seenemikk/LibreWatch-HW/README.md

# LibreWatch-HW

This repository contains hardware related files for [LibreWatch](https://github.com/seenemikk/LibreWatch) smartwatch.
