seenemikk/LibreWatch-HW/housing/bottom.stl

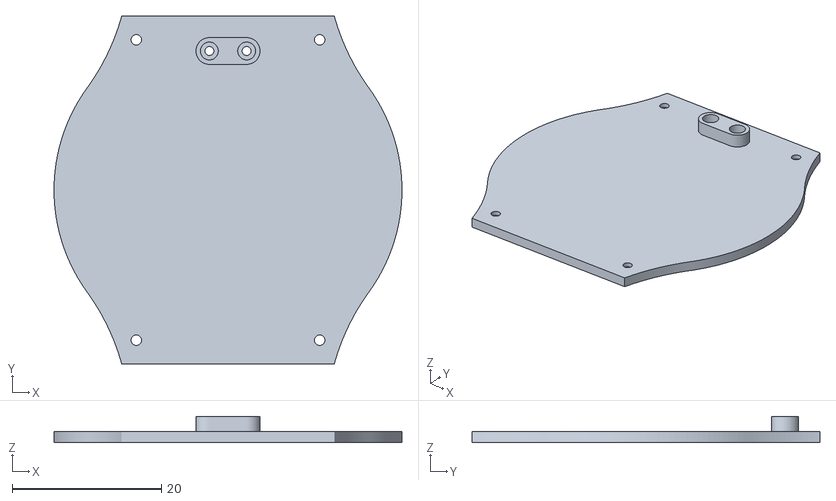
[picture p1: CAD file, 2023-06-04]
housing/bottom.stl
46.7 x 46.7 x 3.50
