seenemikk/LibreWatch-HW/housing/top.stl

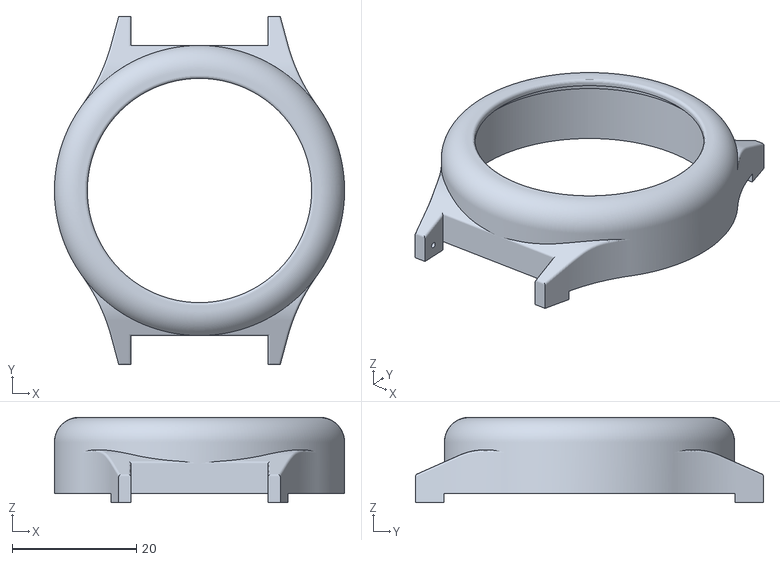
[picture p2: CAD file, 2023-06-04]
housing/top.stl
46.7 x 56.0 x 13.7
