seenemikk/LibreWatch-HW/electronics/doc/schematic.pdf

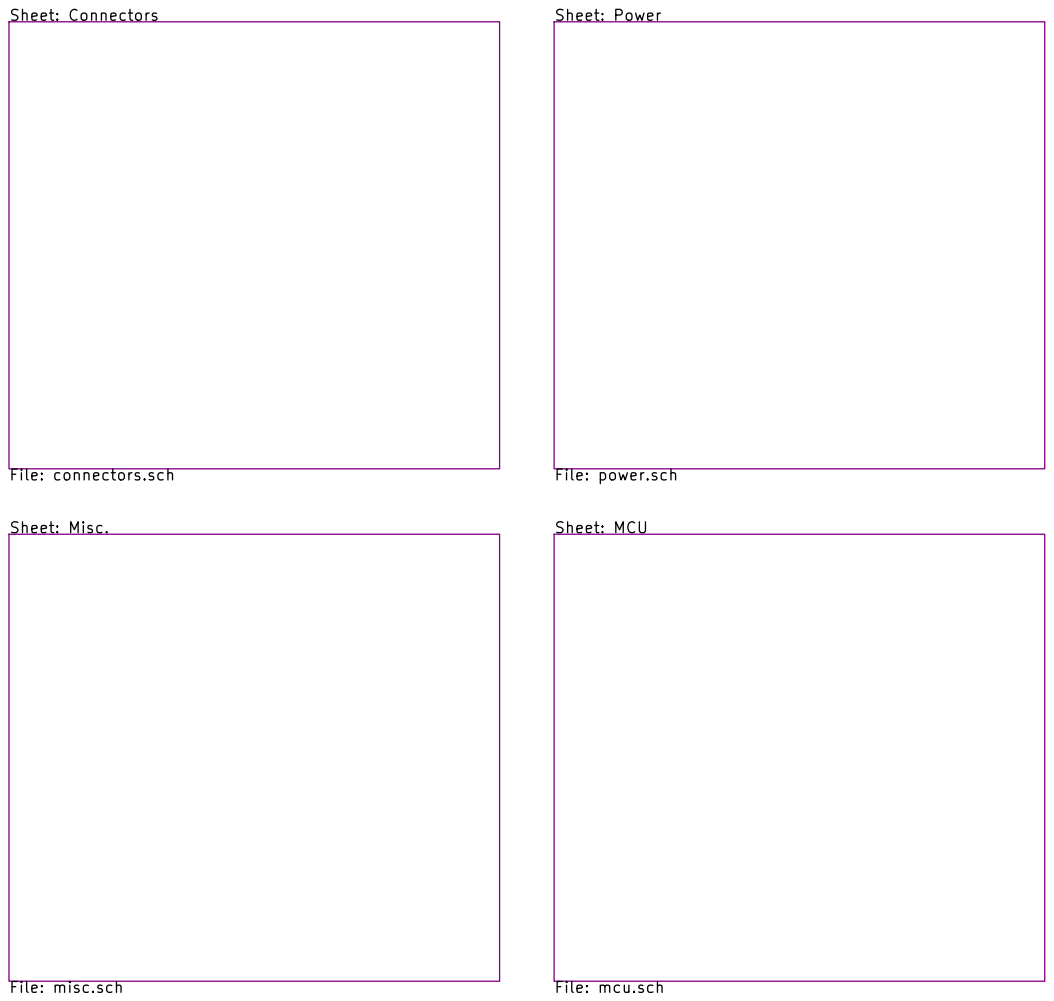
[picture p3: page 1]

Id: 1/5 Title: File: SmartWatch.sch Sheet: /

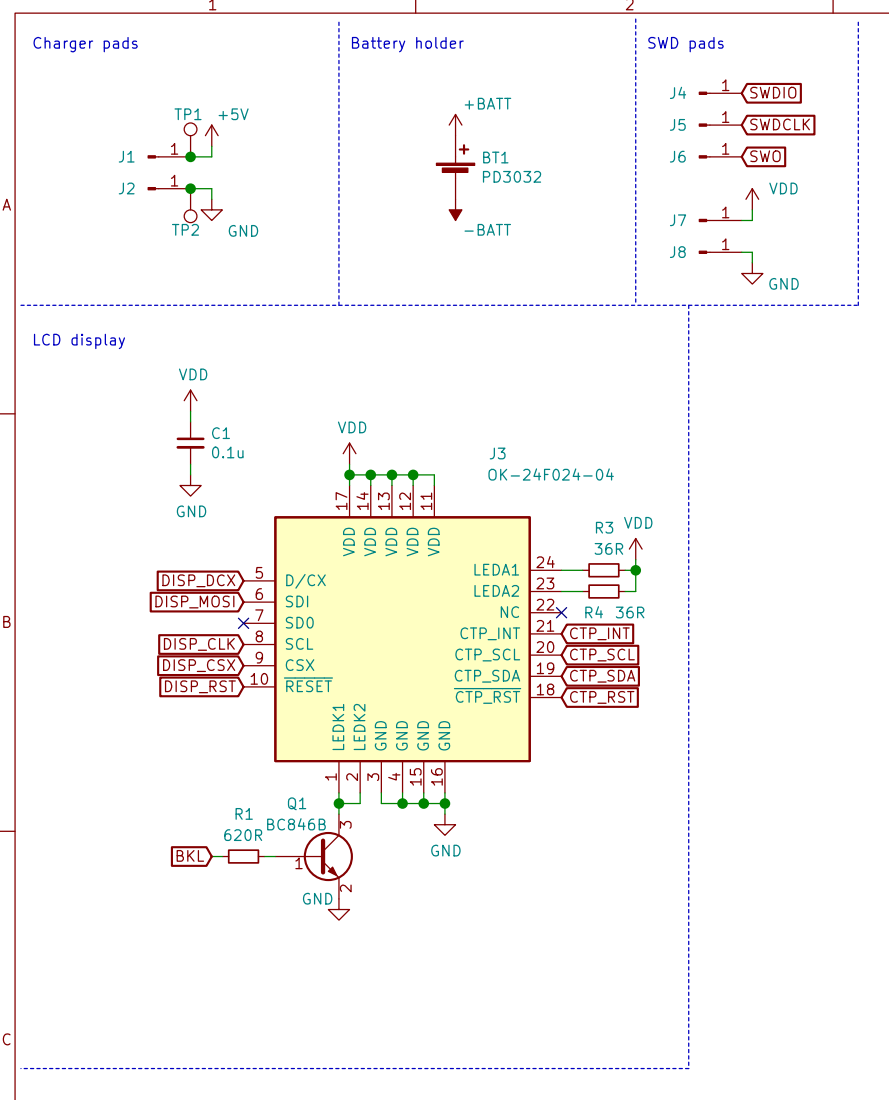
[picture p4: page 2]

1 RESET 10 VDD 11 VDD 12 VDD 13 VDD 14 GND 15 GND 16 VDD 17 CTP_RST 18 CTP_SDA 19 LEDK2

4 D/CX 5 SDI 6 SD0 7 SCL 8 CSX 9

File: connectors.sch Sheet: /Connectors/ GND

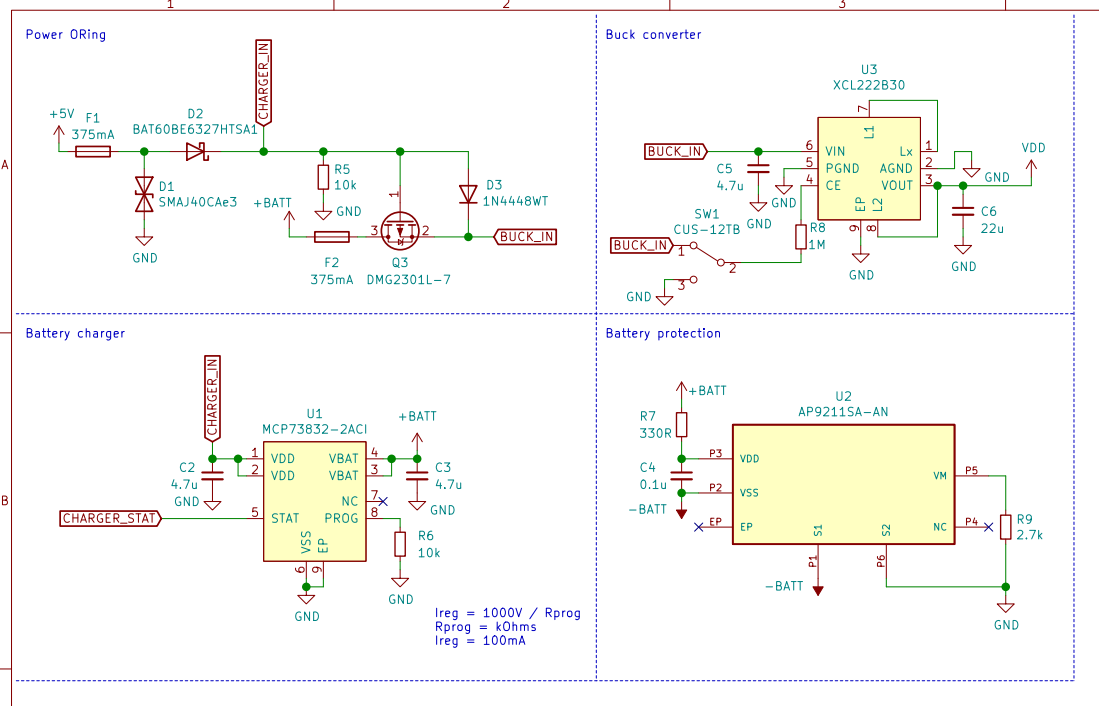
[picture p5: page 3]

File: power.sch Sheet: /Power/
Id: 3/5 Title: Power

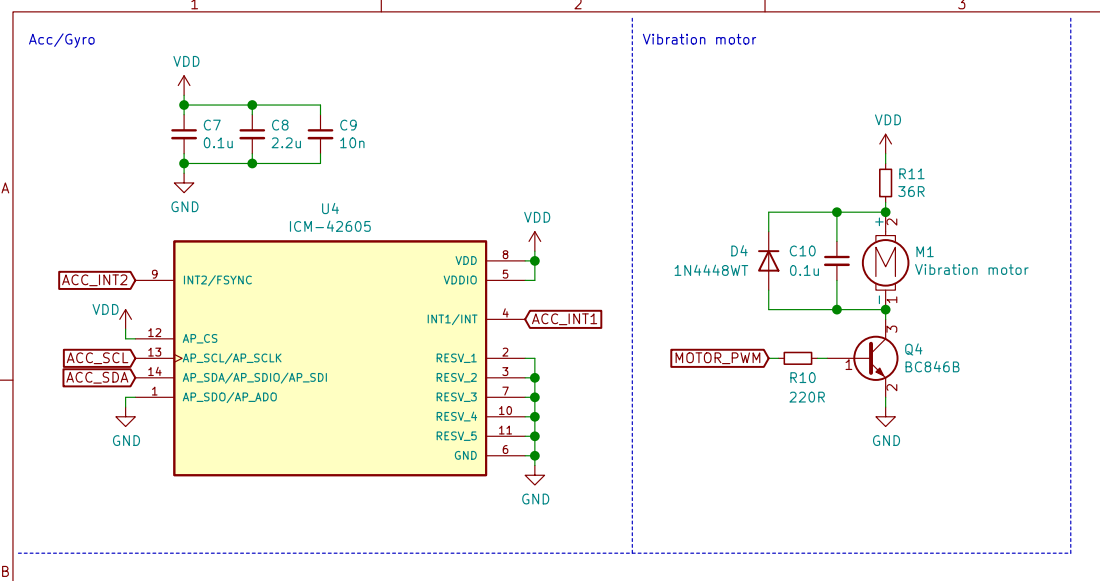
[picture p6: page 4]

Id: 4/5 Title: Misc. File: misc.sch Sheet: /Misc./

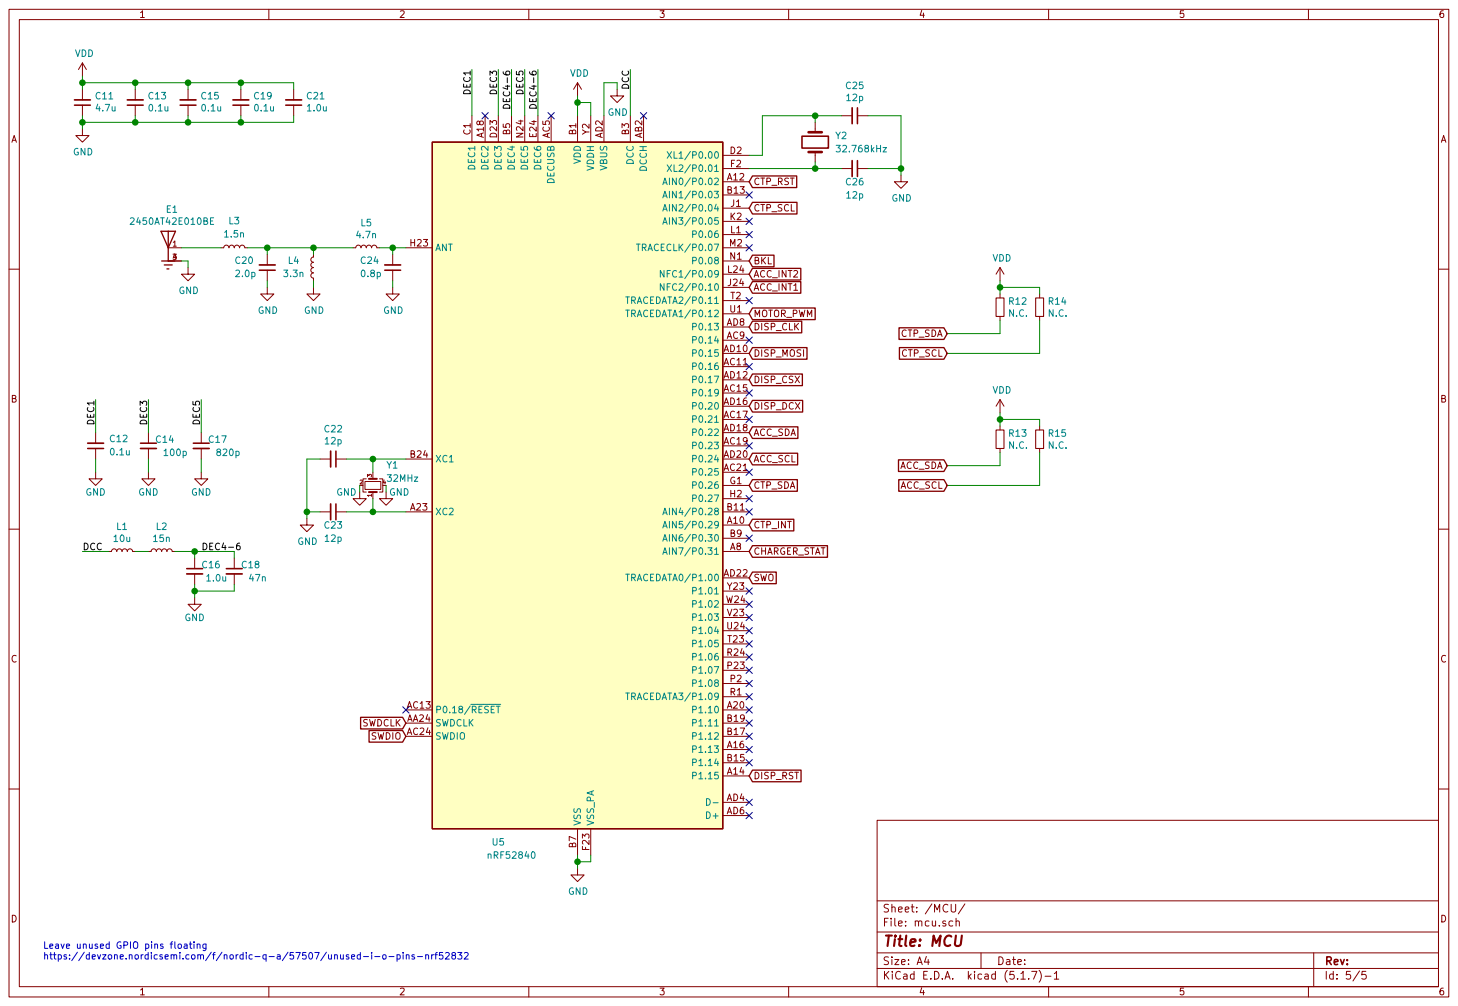
[picture p7: page 5]

File: mcu.sch Sheet: /MCU/
Id: 5/5 Title: MCU

Leave unused GPIO pins floating
https://devzone.nordicsemi.com/f/nordic-q-a/57507/unused-i-o-pins-nrf52832
