seenemikk/LibreWatch-HW/electronics/src/SmartWatch.kicad_pcb

## KiCad design electronics/src/SmartWatch.kicad_pcb (2023-06-04)

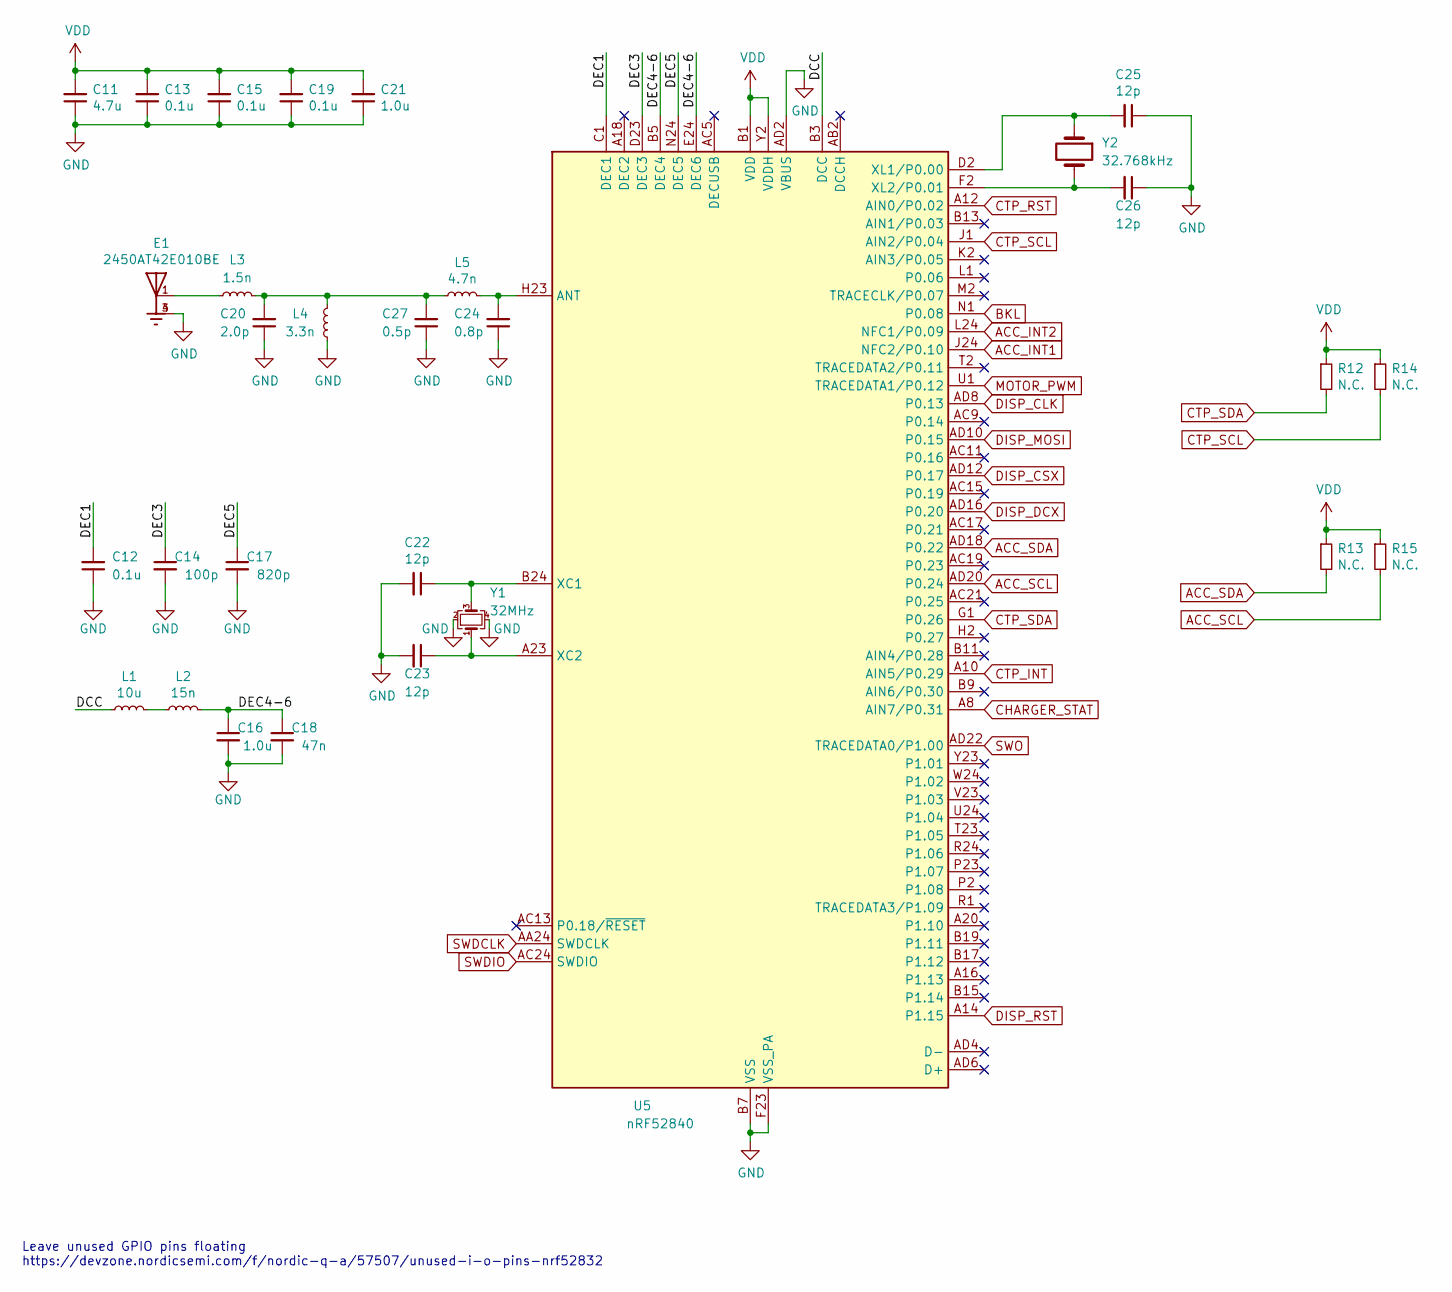
[picture p8: schematic mcu.kicad_sch]

Parts:
C11: 4.7u; C_0603_1608Metric
C12, C13, C15, C19: 0.1u; C_0402_1005Metric
C14: 100p; C_0402_1005Metric
C16, C21: 1.0u; C_0603_1608Metric
C17: 820p; C_0402_1005Metric
C18: 47n; C_0402_1005Metric
C20: 2.0p; C_0402_1005Metric
C22, C23, C25, C26: 12p; C_0402_1005Metric
C24: 0.8p; C_0402_1005Metric
C27: 0.5p; C_0402_1005Metric
E1: 2450AT42E010BE; XDCR_2450AT42E010BE; PARTREV 1.3
L1: 10u; L_0603_1608Metric
L2: 15n; L_0402_1005Metric
L3: 1.5n; L_0402_1005Metric
L4: 3.3n; L_0402_1005Metric
L5: 4.7n; L_0402_1005Metric
R12, R13, R14, R15: N.C.; R_0402_1005Metric
U5: nRF52840; Nordic_AQFN-73-1EP_7x7mm_P0.5mm
Y1: 32MHz; Crystal_SMD_2016-4Pin_2.0x1.6mm
Y2: 32.768kHz; Crystal_SMD_2012-2Pin_2.0x1.2mm

Connections:
/MCU/DCC: L1.1, U5.B3 (DCC)
/MCU/DEC1: C12.2, U5.C1 (DEC1)
/MCU/DEC3: C14.1, U5.D23 (DEC3)
/MCU/DEC4-6: C16.1, C18.1, L2.2, U5.B5 (DEC4), U5.E24 (DEC6)
/MCU/DEC5: C17.1, U5.N24 (DEC5)
ACC_INT1: U5.J24 (NFC2/P0.10); also elsewhere on the board
ACC_INT2: U5.L24 (NFC1/P0.09); also elsewhere on the board
ACC_SCL: R15.2, U5.AD20 (P0.24); also elsewhere on the board
ACC_SDA: R13.2, U5.AD18 (P0.22); also elsewhere on the board
BKL: U5.N1 (P0.08); also elsewhere on the board
CHARGER_STAT: U5.A8 (AIN7/P0.31); also elsewhere on the board
CTP_INT: U5.A10 (AIN5/P0.29); also elsewhere on the board
CTP_RST: U5.A12 (AIN0/P0.02); also elsewhere on the board
CTP_SCL: R14.2, U5.J1 (AIN2/P0.04); also elsewhere on the board
CTP_SDA: R12.2, U5.G1 (P0.26); also elsewhere on the board
DISP_CLK: U5.AD8 (P0.13); also elsewhere on the board
DISP_CSX: U5.AD12 (P0.17); also elsewhere on the board
DISP_DCX: U5.AD16 (P0.20); also elsewhere on the board
DISP_MOSI: U5.AD10 (P0.15); also elsewhere on the board
DISP_RST: U5.A14 (P1.15); also elsewhere on the board
GND: C11.1, C12.1, C13.1, C14.2, C15.1, C16.2, C17.2, C18.2, C19.1, C20.1, C21.1, C22.2, C23.2, C24.1, C25.1, C26.1, C27.1, E1.3, E1.4, L4.1, U5.AD2 (VBUS), U5.B7 (VSS), U5.EP (VSS), U5.F23 (VSS_PA), Y1.2, Y1.4; also elsewhere on the board
MOTOR_PWM: U5.U1 (TRACEDATA1/P0.12); also elsewhere on the board
unnamed: C20.2, C27.2, L3.2, L4.2, L5.1
unnamed: C22.1, U5.B24 (XC1), Y1.3
unnamed: C23.1, U5.A23 (XC2), Y1.1
unnamed: C24.2, L5.2, U5.H23 (ANT)
unnamed: C25.2, U5.D2 (XL1/P0.00), Y2.1
unnamed: C26.2, U5.F2 (XL2/P0.01), Y2.2
unnamed: E1.1, L3.1
unnamed: L1.2, L2.1
SWDCLK: U5.AA24 (SWDCLK); also elsewhere on the board
SWDIO: U5.AC24 (SWDIO); also elsewhere on the board
SWO: U5.AD22 (TRACEDATA0/P1.00); also elsewhere on the board
VDD: C11.2, C13.2, C15.2, C19.2, C21.2, R12.1, R13.1, R14.1, R15.1, U5.A22 (VDD), U5.AD14 (VDD), U5.AD23 (VDD), U5.B1 (VDD), U5.W1 (VDD), U5.Y2 (VDDH); also elsewhere on the board

Notes on the sheet:
Leave unused GPIO pins floating https://devzone.nordicsemi.com/f/nordic-q-a/57507/unused-i-o-pins-nrf52832

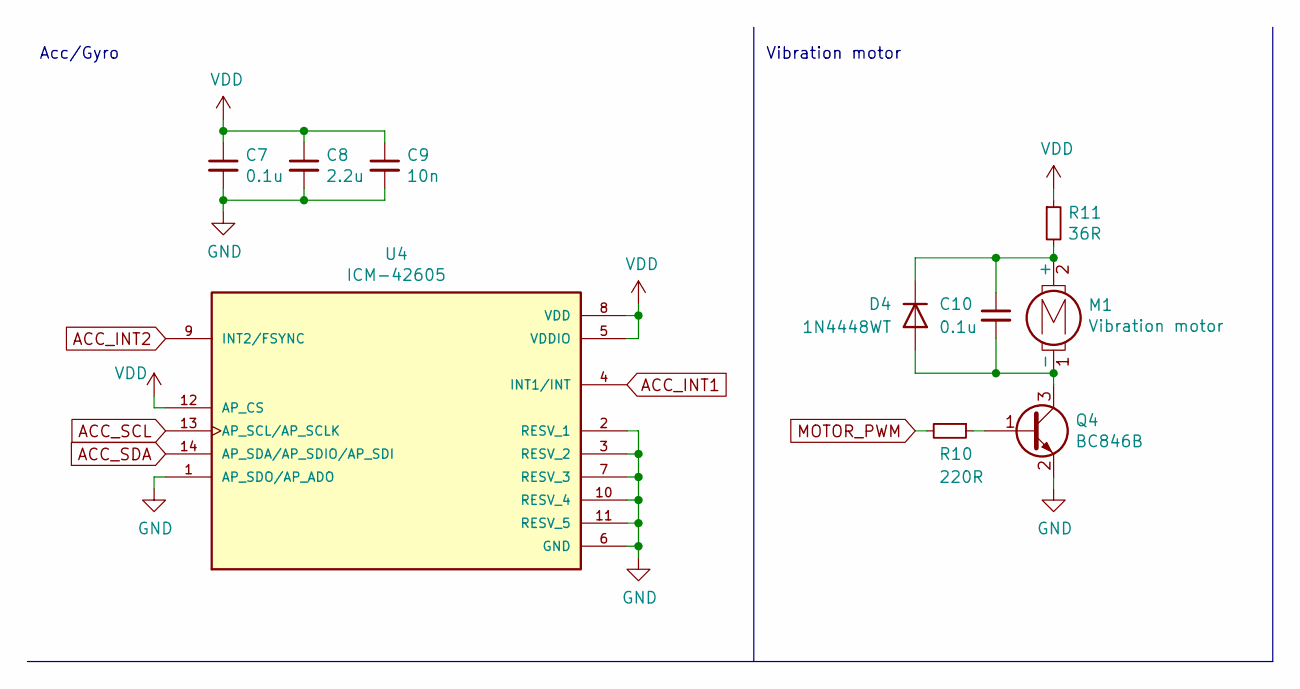
[picture p9: schematic misc.kicad_sch]

Parts:
C7: 0.1u; C_0402_1005Metric
C8: 2.2u; C_0402_1005Metric
C9: 10n; C_0402_1005Metric
C10: 0.1u; C_0603_1608Metric
D4: 1N4448WT; SOD-523F
M1: Vibration motor; Battery_Pads
Q4: BC846B; SOT-23
R10: 220R; R_0402_1005Metric
R11: 36R; R_0603_1608Metric
U4: ICM-42605; PQFN50P300X250X97-14N; PARTREV 0.4

Connections:
ACC_INT1: U4.4 (INT1/INT); also elsewhere on the board
ACC_INT2: U4.9 (INT2/FSYNC); also elsewhere on the board
ACC_SCL: U4.13 (AP_SCL/AP_SCLK); also elsewhere on the board
ACC_SDA: U4.14 (AP_SDA/AP_SDIO/AP_SDI); also elsewhere on the board
GND: C7.2, C8.2, C9.2, Q4.2 (E), U4.1 (AP_SDO/AP_ADO), U4.2 (RESV_1), U4.3 (RESV_2), U4.6 (GND), U4.7 (RESV_3), U4.10 (RESV_4), U4.11 (RESV_5); also elsewhere on the board
MOTOR_PWM: R10.2; also elsewhere on the board
unnamed: C10.1, D4.1 (K), M1.2 (+), R11.2
unnamed: C10.2, D4.2 (A), M1.1 (-), Q4.3 (C)
unnamed: Q4.1 (B), R10.1
VDD: C7.1, C8.1, C9.1, R11.1, U4.5 (VDDIO), U4.8 (VDD), U4.12 (AP_CS); also elsewhere on the board

Notes on the sheet:
Acc/Gyro
Vibration motor

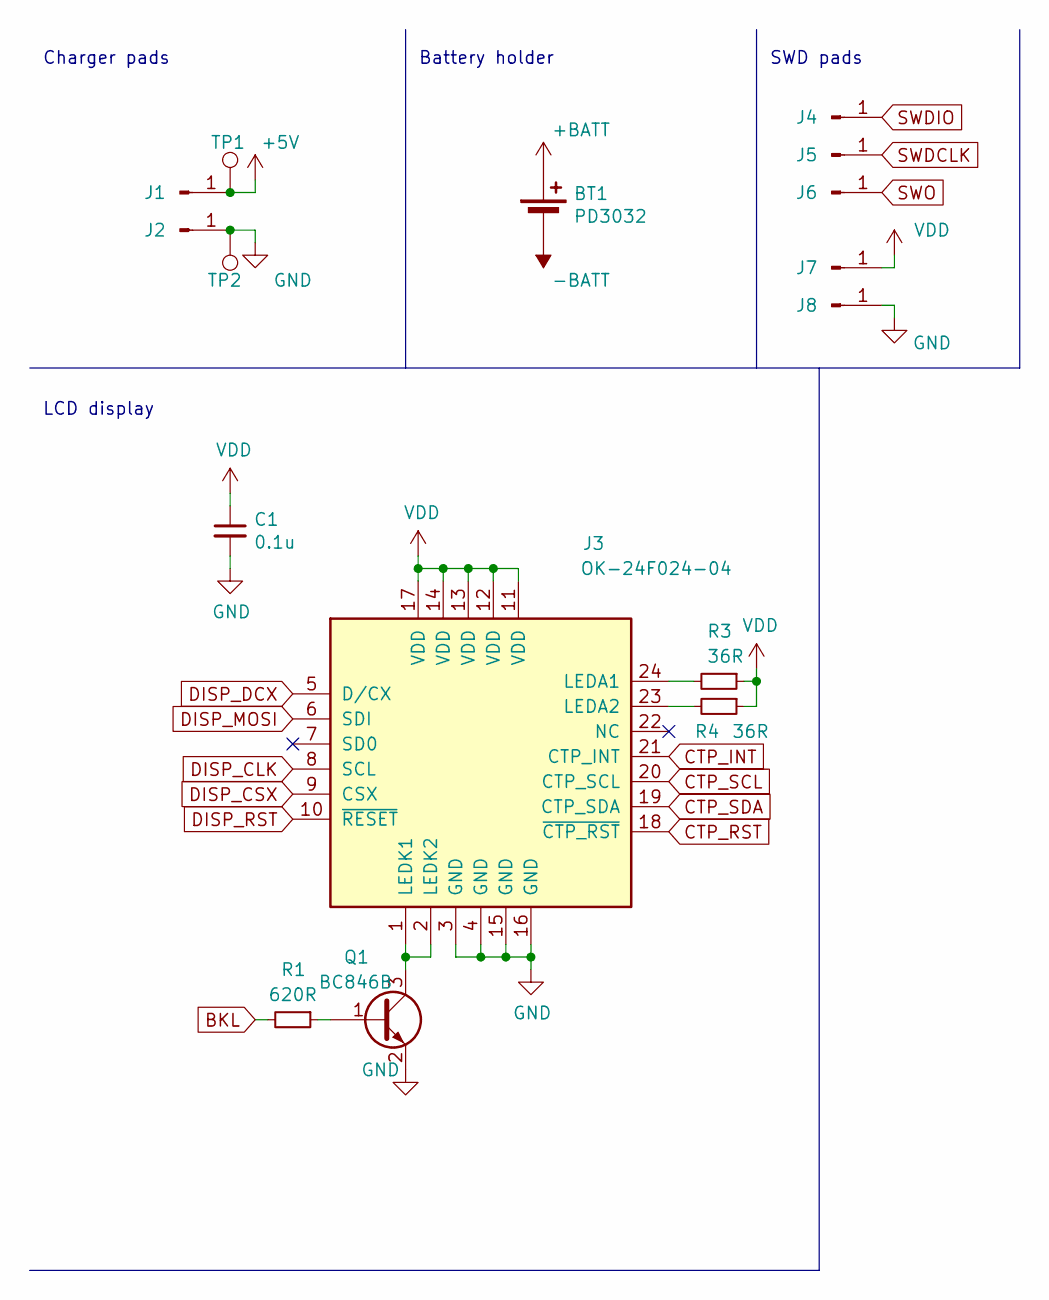
[picture p10: schematic connectors.kicad_sch]

Parts:
BT1: PD3032; Battery_Pads
C1: 0.1u; C_0402_1005Metric
J1, J2: P70-2010045R; TestPoint_Pad_D1.5mm
J3: OK-24F024-04
J4, J5, J6, J7, J8: P70-2010045R; TestPoint_Pad_D2.5mm
Q1: BC846B; SOT-23
R1: 620R; R_0402_1005Metric
R3, R4: 36R; R_0402_1005Metric
TP1, TP2: TestPoint; TestPoint_Pad_D1.5mm

Connections:
+5V: J1.1, TP1.1; also elsewhere on the board
+BATT: BT1.1 (+); also elsewhere on the board
-BATT: BT1.2 (-); also elsewhere on the board
BKL: R1.2; also elsewhere on the board
CTP_INT: J3.21 (CTP_INT); also elsewhere on the board
CTP_RST: J3.18 (~CTP_RST); also elsewhere on the board
CTP_SCL: J3.20 (CTP_SCL); also elsewhere on the board
CTP_SDA: J3.19 (CTP_SDA); also elsewhere on the board
DISP_CLK: J3.8 (SCL); also elsewhere on the board
DISP_CSX: J3.9 (CSX); also elsewhere on the board
DISP_DCX: J3.5 (D/CX); also elsewhere on the board
DISP_MOSI: J3.6 (SDI); also elsewhere on the board
DISP_RST: J3.10 (~RESET); also elsewhere on the board
GND: C1.2, J2.1, J3.3 (GND), J3.4 (GND), J3.15 (GND), J3.16 (GND), J8.1, Q1.2 (E), TP2.1; also elsewhere on the board
unnamed: J3.1 (LEDK1), J3.2 (LEDK2), Q1.3 (C)
unnamed: J3.23 (LEDA2), R4.2
unnamed: J3.24 (LEDA1), R3.2
unnamed: Q1.1 (B), R1.1
SWDCLK: J5.1; also elsewhere on the board
SWDIO: J4.1; also elsewhere on the board
SWO: J6.1; also elsewhere on the board
VDD: C1.1, J3.11 (VDD), J3.12 (VDD), J3.13 (VDD), J3.14 (VDD), J3.17 (VDD), J7.1, R3.1, R4.1; also elsewhere on the board

Notes on the sheet:
SWD pads
Battery holder
LCD display
Charger pads

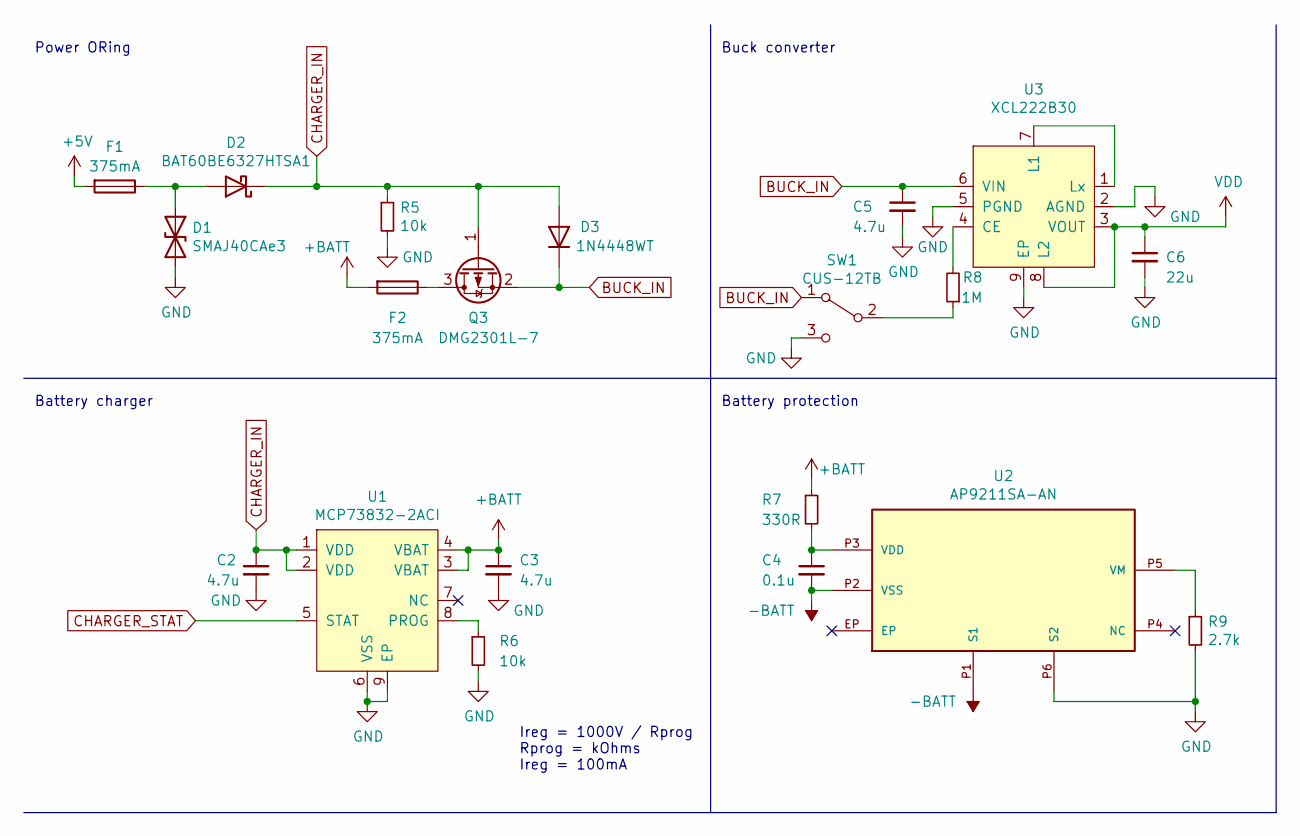
[picture p11: schematic power.kicad_sch]

Parts:
C2, C3, C5: 4.7u; C_0603_1608Metric
C4: 0.1u; C_0603_1608Metric
C6: 22u; C_0603_1608Metric
D1: SMAJ40CAe3; D_SMA
D2: BAT60BE6327HTSA1; D_SOD-323
D3: 1N4448WT; SOD-523F
F1, F2: 375mA; Fuse_0603_1608Metric
Q3: DMG2301L-7; SOT-23
R5, R6: 10k; R_0402_1005Metric
R7: 330R; R_0603_1608Metric
R8: 1M; R_0402_1005Metric
R9: 2.7k; R_0603_1608Metric
SW1: CUS-12TB; CUS-12B
U1: MCP73832-2ACI
U2: AP9211SA-AN; U-DFN2030-6
U3: XCL222B30; VREG_XCL220B283FR-G

Connections:
+5V: F1.2; also elsewhere on the board
+BATT: C3.1, F2.2, R7.1, U1.3 (VBAT), U1.4 (VBAT); also elsewhere on the board
-BATT: C4.2, U2.P1 (S1), U2.P2 (VSS); also elsewhere on the board
BUCK_IN: C5.1, D3.1 (K), Q3.2 (S), SW1.1 (A), U3.6 (VIN)
CHARGER_IN: C2.1, D2.1 (K), D3.2 (A), Q3.1 (G), R5.1, U1.1 (VDD), U1.2 (VDD)
CHARGER_STAT: U1.5 (STAT); also elsewhere on the board
GND: C2.2, C3.2, C5.2, C6.2, D1.2 (A2), R5.2, R6.2, R9.2, SW1.3 (C), U1.6 (VSS), U1.9 (EP), U2.P6 (S2), U3.2 (AGND), U3.5 (PGND), U3.9 (EP); also elsewhere on the board
unnamed: C4.1, R7.2, U2.P3 (VDD)
unnamed: D1.1 (A1), D2.2 (A), F1.1
unnamed: F2.1, Q3.3 (D)
unnamed: R6.1, U1.8 (PROG)
unnamed: R8.1, SW1.2 (B)
unnamed: R8.2, U3.4 (CE)
unnamed: R9.1, U2.P5 (VM)
unnamed: U3.1 (Lx), U3.7 (L1)
VDD: C6.1, U3.3 (VOUT), U3.8 (L2); also elsewhere on the board

Notes on the sheet:
Power ORing
Battery protection
Ireg = 1000V / Rprog Rprog = kOhms Ireg = 100mA
Buck converter
Battery charger

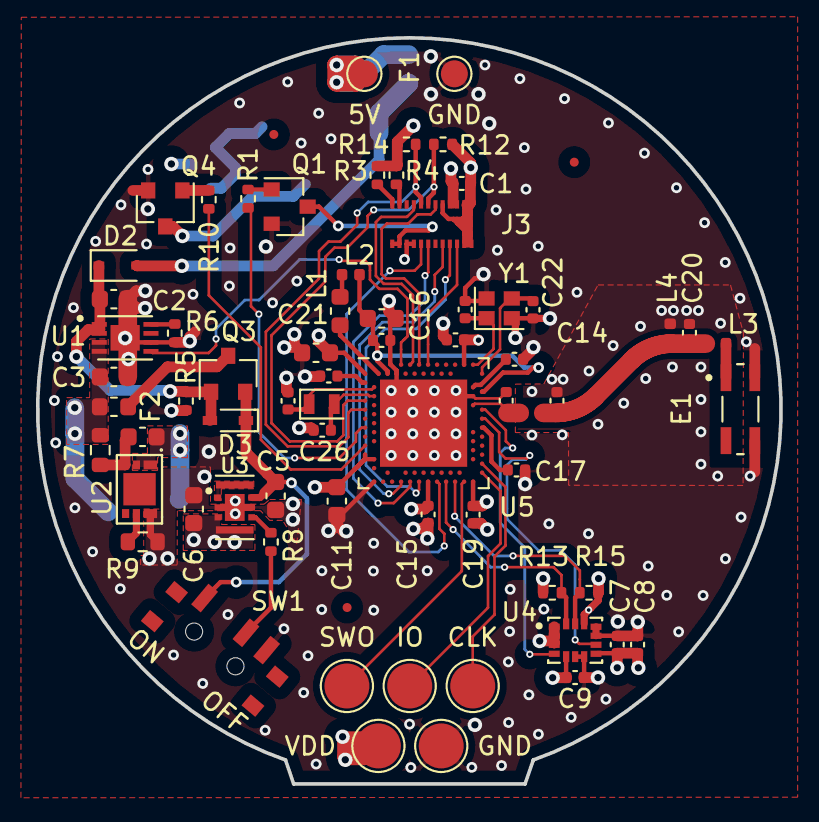
[picture p12: board SmartWatch.kicad_pcb from above]

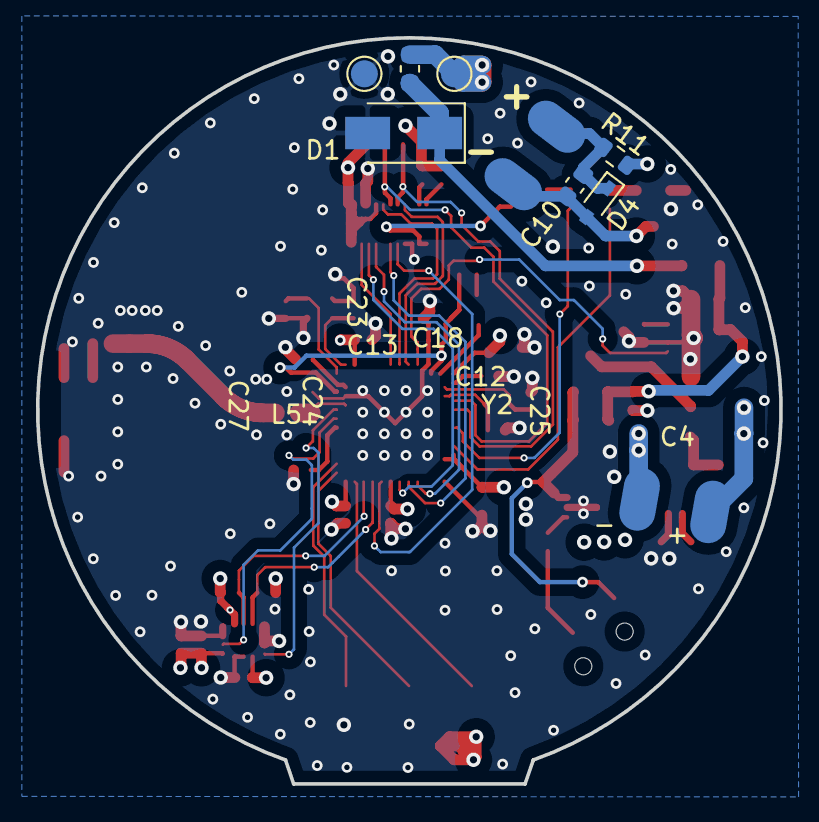
[picture p13: board SmartWatch.kicad_pcb from below]

Board: 4 copper layers, 41.3 x 41.5 mm, 76 parts (9 on the bottom side), 54 nets.
